williamhgg03/ProjektKurs/README.md

# ProjektKurs
Repository for anything relating to D7039E and D7032E for the "Gadget/Toy" group.
