williamhgg03/ProjektKurs/report/main.tex

\documentclass[11pt,a4paper]{article}

\input{preamble}
\input{macros}
\input{metadata}

\begin{document}

\maketitle

\input{sections/00-abstract}
\input{sections/01-introduction}
\input{sections/02-background}
\input{sections/03-method}
\input{sections/04-implementation}
\input{sections/05-results}
\input{sections/06-discussion}
\input{sections/07-conclusion}

\printbibliography
\end{document}
