williamhgg03/ProjektKurs/CAD/body part.stl

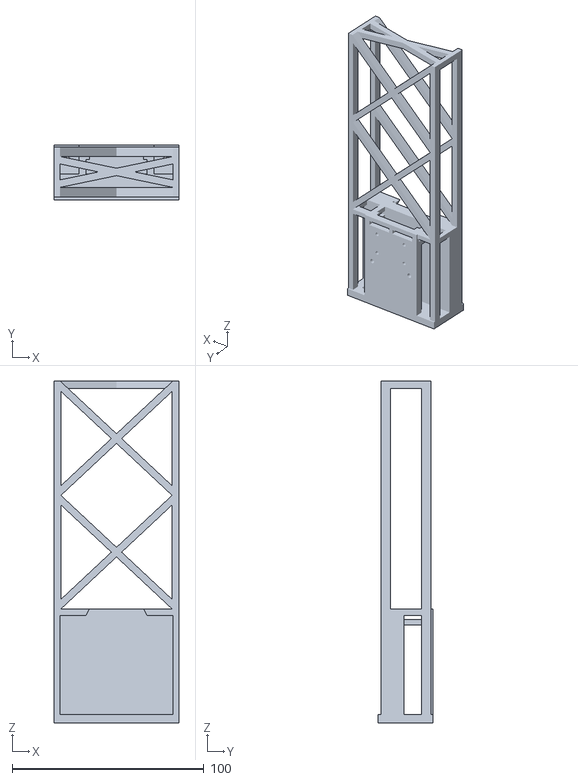
[picture p1: CAD file, 2026-11-03]
CAD/body part.stl
65.0 x 28.5 x 178.4
