williamhgg03/ProjektKurs/(commit log)

2026-09-16 wifi testing for esp32
2026-09-23 ESP32-S3 colour update
2026-09-25 celanup and led strip
2026-09-25 led stip and cleanup actuall commit
2026-10-02 final merge detail + led fixing
    [build.rs, led_driver.rs, main.rs]
2026-10-07 CAD file for body
    [Untitled 1.ods]
2026-10-10 added support for the powerbank
2026-11-03 body part but stl
2026-11-08 testing pitch correction
